yaturner/tcam-p1s-mount/docs/grid2.png

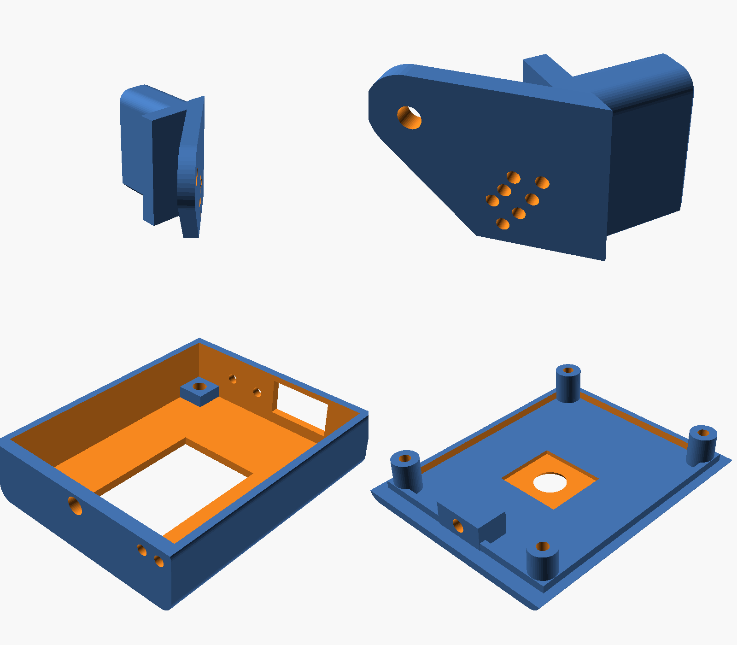
docs/grid2.png
