yaturner/tcam-p1s-mount/docs/top_40.png

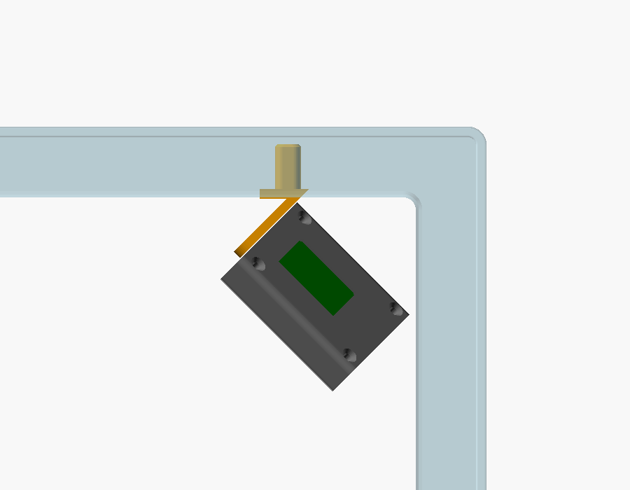
docs/top_40.png
