yaturner/tcam-p1s-mount/stl/case_base.stl

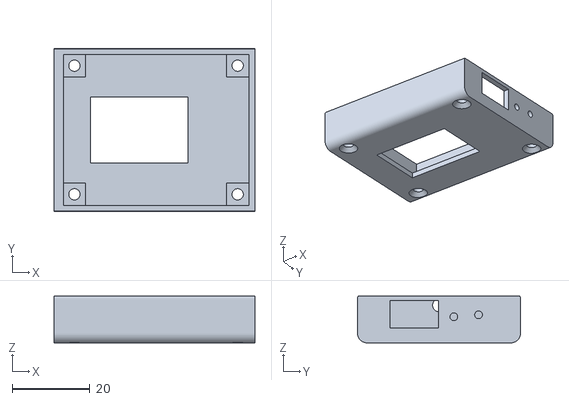
[picture p6: CAD file, 2026-11-11]
stl/case_base.stl
51.6 x 41.9 x 12.0
