yaturner/tcam-p1s-mount/stl/bracket_tape.stl

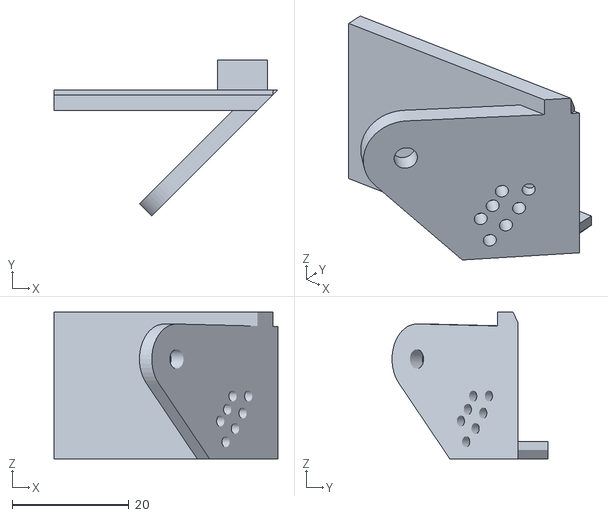
[picture p7: CAD file, 2026-11-11]
stl/bracket_tape.stl
38.3 x 26.7 x 25.1
