yaturner/tcam-p1s-mount/stl/bracket_corner.stl

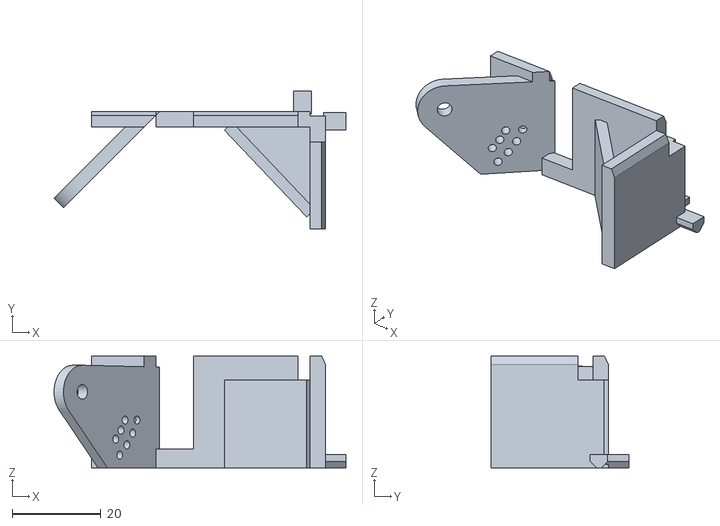
[picture p8: CAD file, 2026-11-11]
stl/bracket_corner.stl
65.6 x 31.0 x 25.1
