yaturner/tcam-p1s-mount/stl/bracket.stl

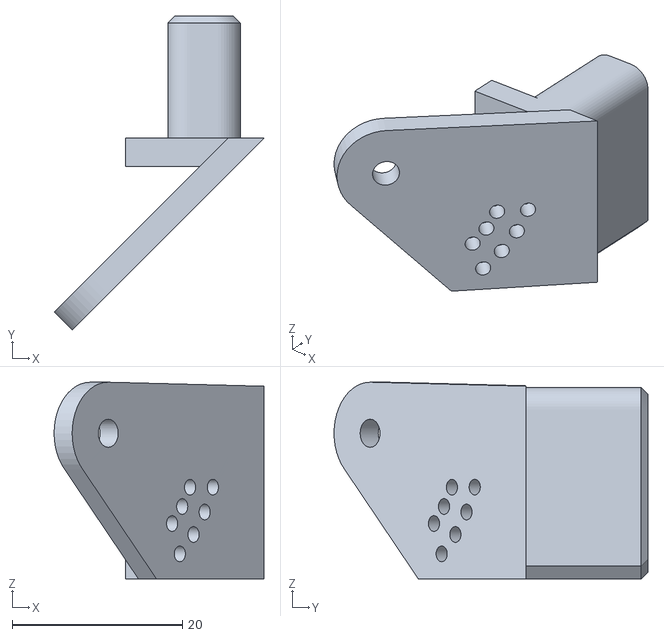
[picture p9: CAD file, 2026-11-11]
stl/bracket.stl
24.7 x 36.9 x 23.1
