yaturner/tcam-p1s-mount/docs/corner_assembly.pdf

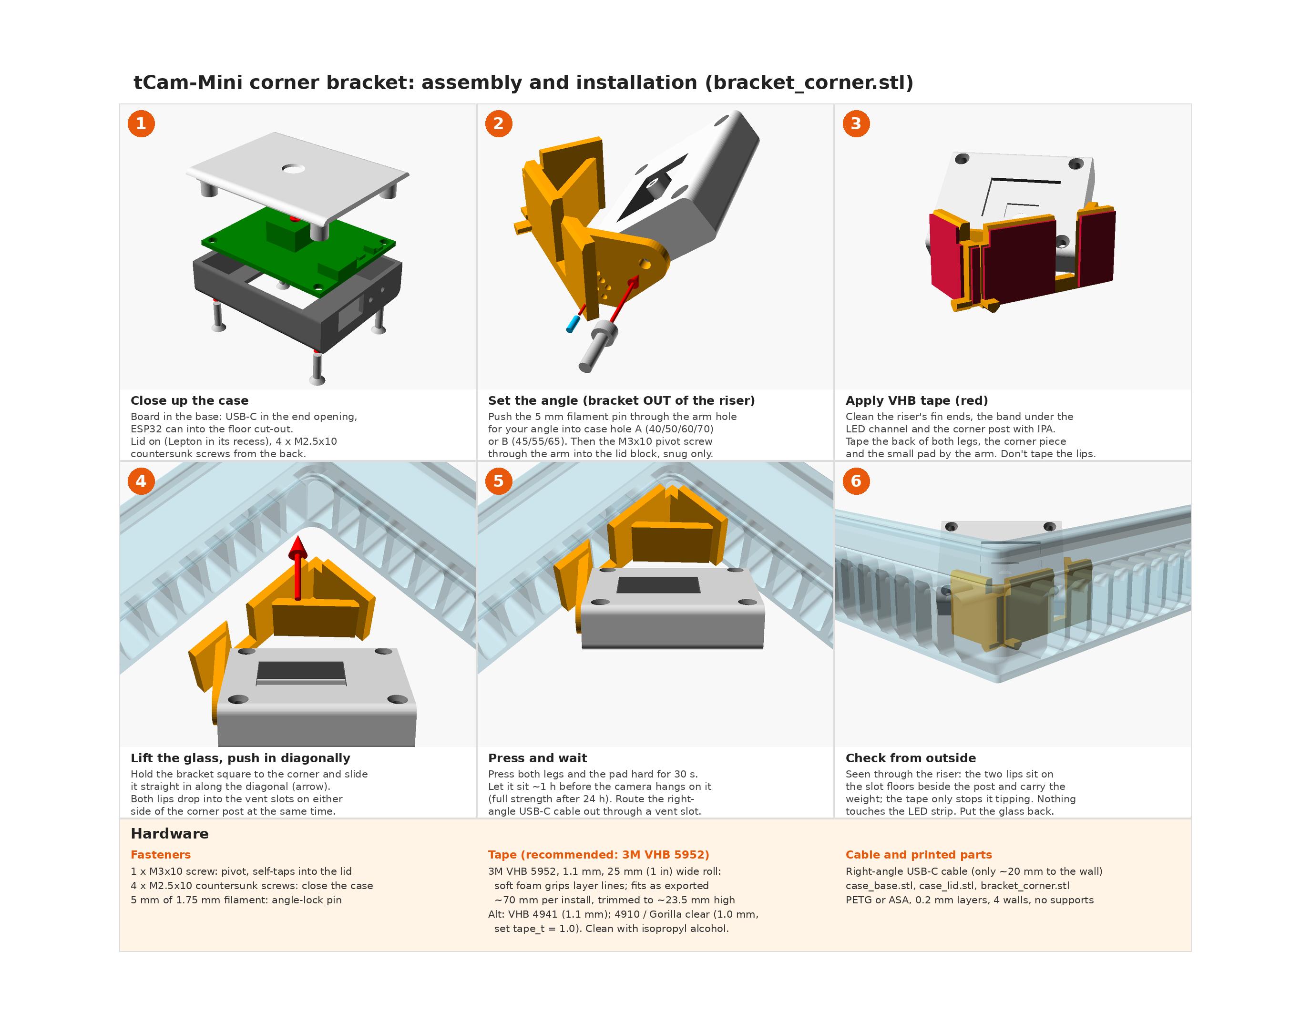
[picture p11: page 1]
