yaturner/tcam-p1s-mount/(commit log)

2026-11-11 tCam-Mini case and tilt mount for a P1S with the Vented LED Riser
    Case, pin-locked 40-70 deg pivot, and three brackets (vent-slot tab,
    VHB pad, VHB corner V), with renders and an assembly diagram.
    [bracket.stl, bracket_corner.stl, bracket_tape.stl, case_base.stl, case_lid.stl, tcam_p1s_mount.scad]
2026-11-11 Add printable PDF of the corner bracket assembly diagram
    US Letter landscape, linked from the README under the diagram.
